PrintsNCode/Mechanical-7-Segment-Countdown/(commit log)

2026-10-20 Initial release: ESP32 firmware and technical documentation
2026-10-20 Add metadata-free wiring diagram to connection guides
